EMLauncher/POV_clock/frame_B.step

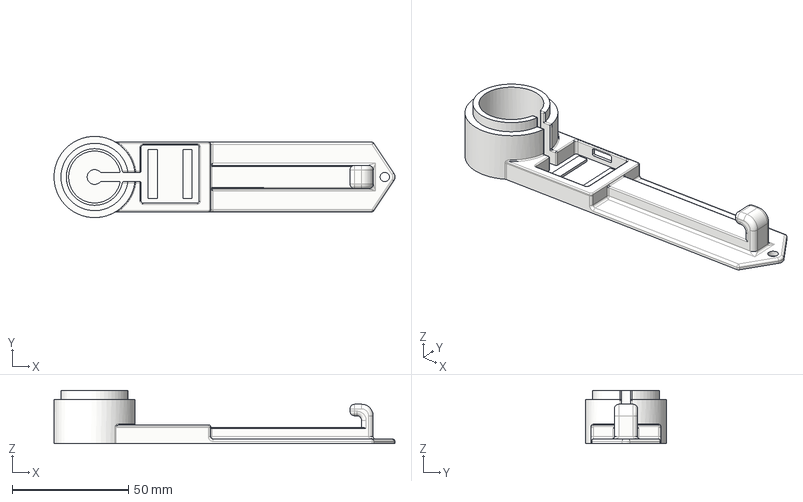
[picture p1: CAD file, 2024-11-16]
frame_B.step
146.9 x 35.0 x 23.0 mm
