EMLauncher/POV_clock/coil_frame_B.step

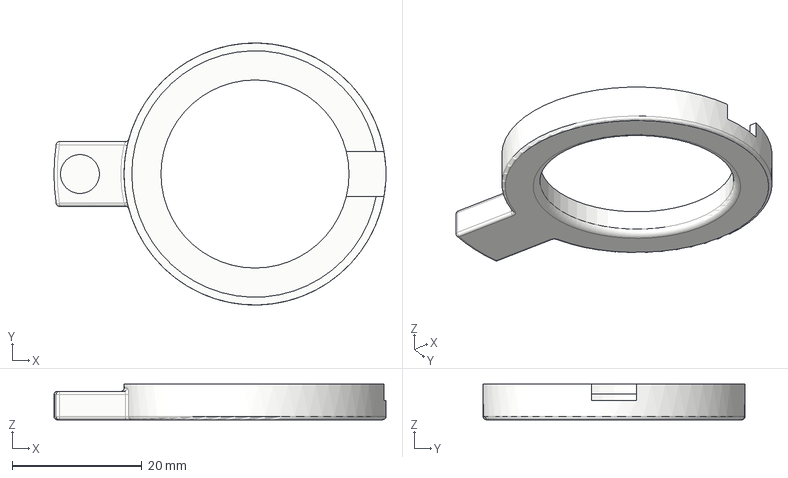
[picture p2: CAD file, 2024-11-16]
coil_frame_B.step
51.2 x 40.4 x 5.50 mm
