EMLauncher/POV_clock/POV_v011_PCB/POV_v011.kicad_pcb

## KiCad design POV_v011_PCB/POV_v011.kicad_pcb (2024-11-16)

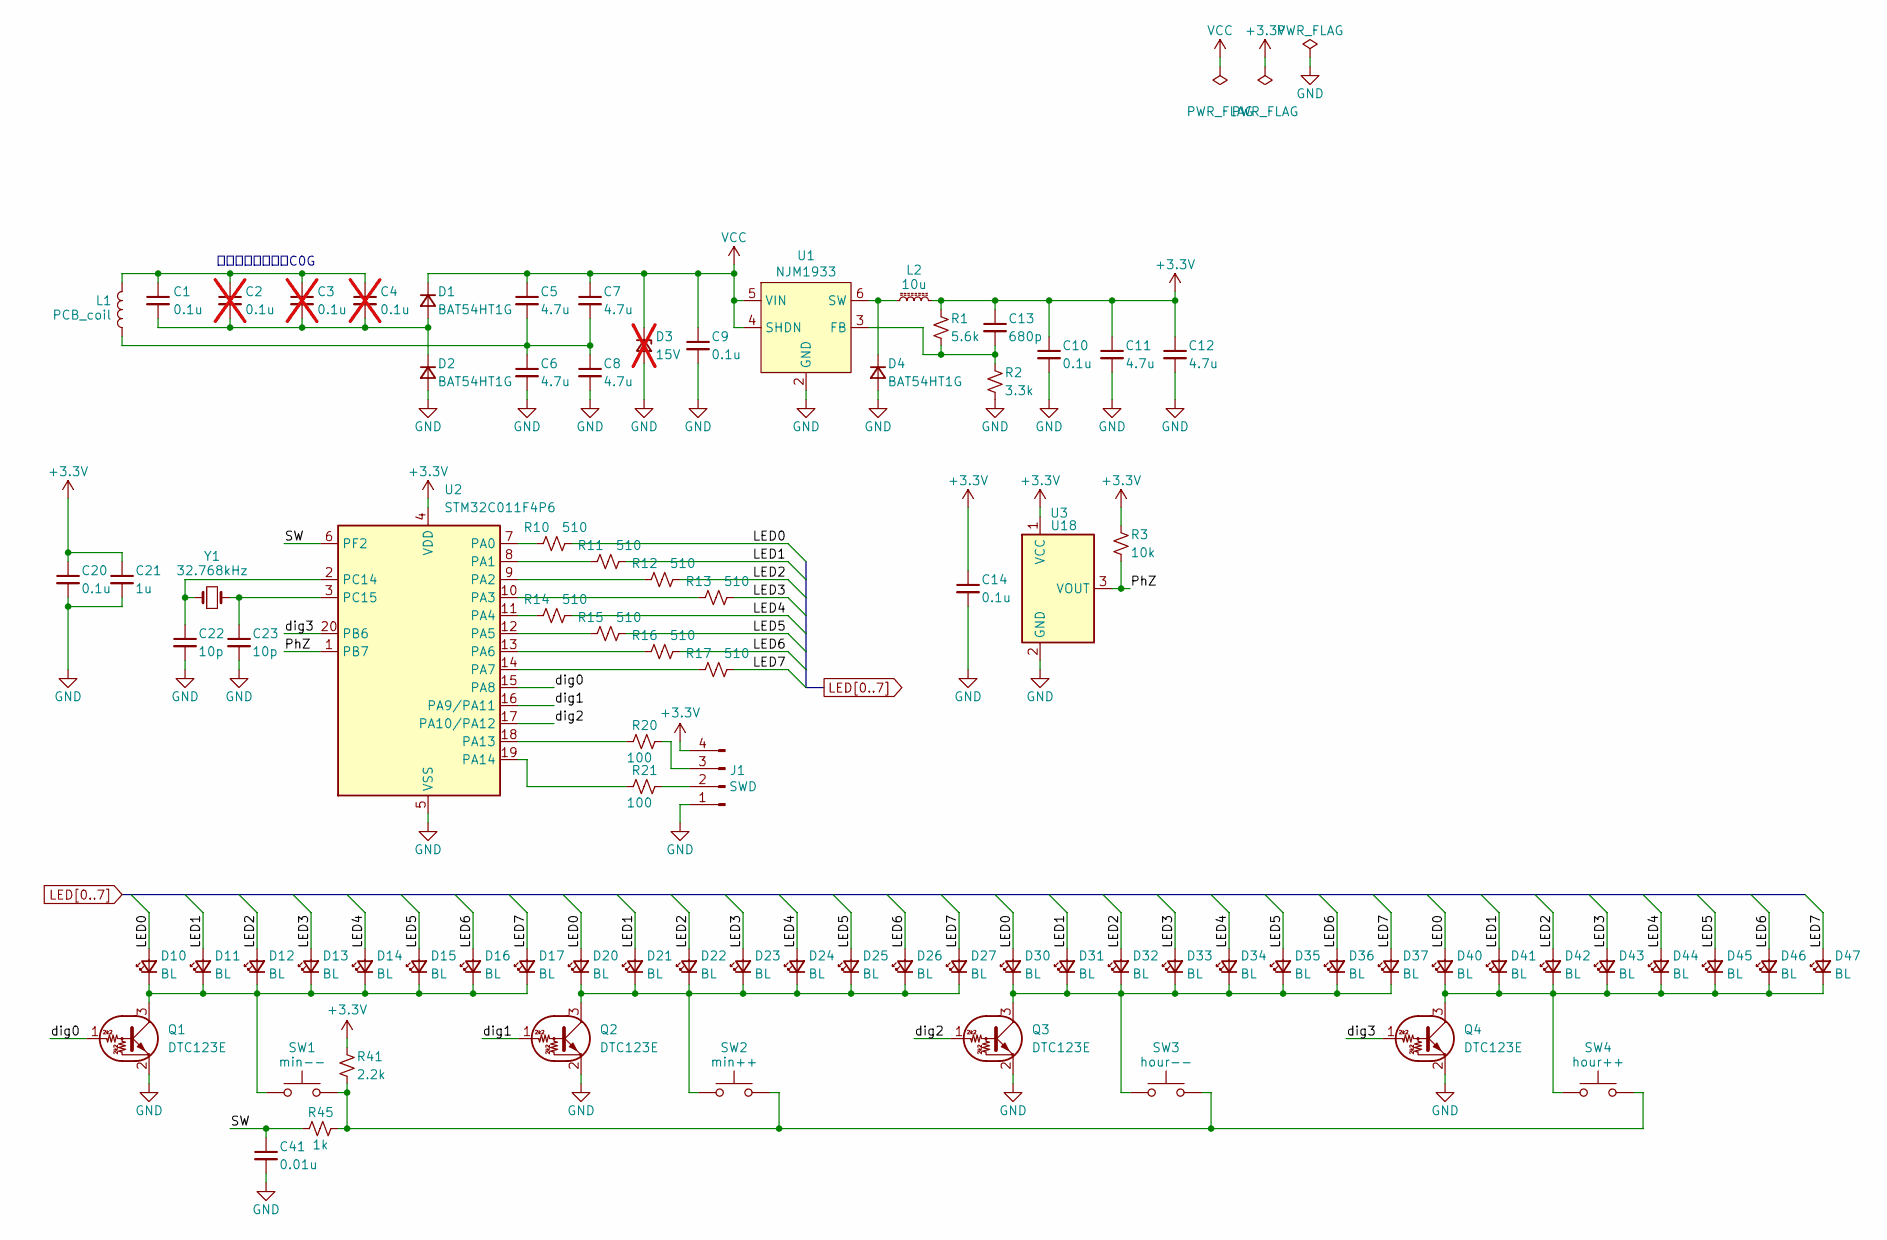
[picture p3: schematic POV_v011.kicad_sch, POV]

Parts:
C1: 0.1u; C_1206_3216Metric
C2, C3, C4: 0.1u; C_1206_3216Metric; not fitted
C5, C6, C7, C8, C11, C12: 4.7u; C_0603_1608Metric
C9, C10, C14, C20: 0.1u; C_0603_1608Metric
C13: 680p; C_0603_1608Metric
C21: 1u; C_0603_1608Metric
C22, C23: 10p; C_0603_1608Metric
C41: 0.01u; C_0603_1608Metric
D1, D2, D4: BAT54HT1G; D_SOD-323
D3: 15V; D_SMA; not fitted
D10, D11, D12, D13, D14, D15, D16, D17, D20, D21, D22, D23, D24, D25, D26, D27, D30, D31, D32, D33, D34, D35, D36, D37, D40, D41, D42, D43, D44, D45, D46, D47: BL; D_0603_1608Metric
J1: SWD; PinHeader_1x04_P2.54mm_Vertical
L1: PCB_coil; PCB_Coil_R15_L2T12
L2: 10u; L_1210_3225Metric
Q1, Q2, Q3, Q4: DTC123E; SOT-323_SC-70
R1: 5.6k; R_0603_1608Metric
R2: 3.3k; R_0603_1608Metric
R3: 10k; R_0603_1608Metric
R10, R11, R12, R13, R14, R15, R16, R17: 510; R_0603_1608Metric
R20, R21: 100; R_0603_1608Metric
R41: 2.2k; R_0603_1608Metric
R45: 1k; R_0603_1608Metric
SW1: min--; SW_Tactile_SPST_NO_Straight_CK_PTS636Sx25SMTRLFS
SW2: min++; SW_Tactile_SPST_NO_Straight_CK_PTS636Sx25SMTRLFS
SW3: hour--; SW_Tactile_SPST_NO_Straight_CK_PTS636Sx25SMTRLFS
SW4: hour++; SW_Tactile_SPST_NO_Straight_CK_PTS636Sx25SMTRLFS
U1: NJM1933; SOT-23-6
U2: STM32C011F4P6; TSSOP-20_4.4x6.5mm_P0.65mm
U3: U18; PinHeader_1x03_P1.27mm_Vertical
Y1: 32.768kHz; Crystal_SMD_3215-2Pin_3.2x1.5mm

Connections:
+3.3V: C10.1, C11.1, C12.1, C13.1, C14.1, C20.1, C21.1, J1.4, L2.2, R1.1, R3.1, R41.1, U2.4 (VDD), U3.1 (VCC)
/PhZ: R3.2, U2.1 (PB7), U3.3 (VOUT)
/SW: C41.1, R45.1, U2.6 (PF2)
/dig0: Q1.1 (B), U2.15 (PA8)
/dig1: Q2.1 (B), U2.16 (PA9/PA11)
/dig2: Q3.1 (B), U2.17 (PA10/PA12)
/dig3: Q4.1 (B), U2.20 (PB6)
GND: C6.2, C8.2, C9.2, C10.2, C11.2, C12.2, C14.2, C20.2, C21.2, C22.2, C23.2, C41.2, D2.2 (A), D3.2 (A), D4.2 (A), J1.1, Q1.2 (E), Q2.2 (E), Q3.2 (E), Q4.2 (E), R2.2, U1.2 (GND), U2.5 (VSS), U3.2 (GND)
LED0: D10.2 (A), D20.2 (A), D30.2 (A), D40.2 (A), R10.2
LED1: D11.2 (A), D21.2 (A), D31.2 (A), D41.2 (A), R11.2
LED2: D12.2 (A), D22.2 (A), D32.2 (A), D42.2 (A), R12.2
LED3: D13.2 (A), D23.2 (A), D33.2 (A), D43.2 (A), R13.2
LED4: D14.2 (A), D24.2 (A), D34.2 (A), D44.2 (A), R14.2
LED5: D15.2 (A), D25.2 (A), D35.2 (A), D45.2 (A), R15.2
LED6: D16.2 (A), D26.2 (A), D36.2 (A), D46.2 (A), R16.2
LED7: D17.2 (A), D27.2 (A), D37.2 (A), D47.2 (A), R17.2
unnamed: C1.1, C2.1, C3.1, C4.1, L1.2
unnamed: C5.2, C6.1, C7.2, C8.1, L1.1
unnamed: C1.2, C2.2, C3.2, C4.2, D1.2 (A), D2.1 (K)
unnamed: D4.1 (K), L2.1, U1.6 (SW)
unnamed: D10.1 (K), D11.1 (K), D12.1 (K), D13.1 (K), D14.1 (K), D15.1 (K), D16.1 (K), D17.1 (K), Q1.3 (C), SW1.1
unnamed: D20.1 (K), D21.1 (K), D22.1 (K), D23.1 (K), D24.1 (K), D25.1 (K), D26.1 (K), D27.1 (K), Q2.3 (C), SW2.1
unnamed: D30.1 (K), D31.1 (K), D32.1 (K), D33.1 (K), D34.1 (K), D35.1 (K), D36.1 (K), D37.1 (K), Q3.3 (C), SW3.1
unnamed: D40.1 (K), D41.1 (K), D42.1 (K), D43.1 (K), D44.1 (K), D45.1 (K), D46.1 (K), D47.1 (K), Q4.3 (C), SW4.1
unnamed: J1.2, R21.2
unnamed: J1.3, R20.2
unnamed: R41.2, R45.2, SW1.2, SW2.2, SW3.2, SW4.2
unnamed: C13.2, R1.2, R2.1, U1.3 (FB)
unnamed: R10.1, U2.7 (PA0)
unnamed: R11.1, U2.8 (PA1)
unnamed: R12.1, U2.9 (PA2)
unnamed: R13.1, U2.10 (PA3)
unnamed: R14.1, U2.11 (PA4)
unnamed: R15.1, U2.12 (PA5)
unnamed: R16.1, U2.13 (PA6)
unnamed: R17.1, U2.14 (PA7)
unnamed: R20.1, U2.18 (PA13)
unnamed: R21.1, U2.19 (PA14)
unnamed: C22.1, U2.2 (PC14), Y1.1
unnamed: C23.1, U2.3 (PC15), Y1.2
VCC: C5.1, C7.1, C9.1, D1.1 (K), D3.1 (K), U1.4 (SHDN), U1.5 (VIN)

Notes on the sheet:
共振キャパシタはC0G

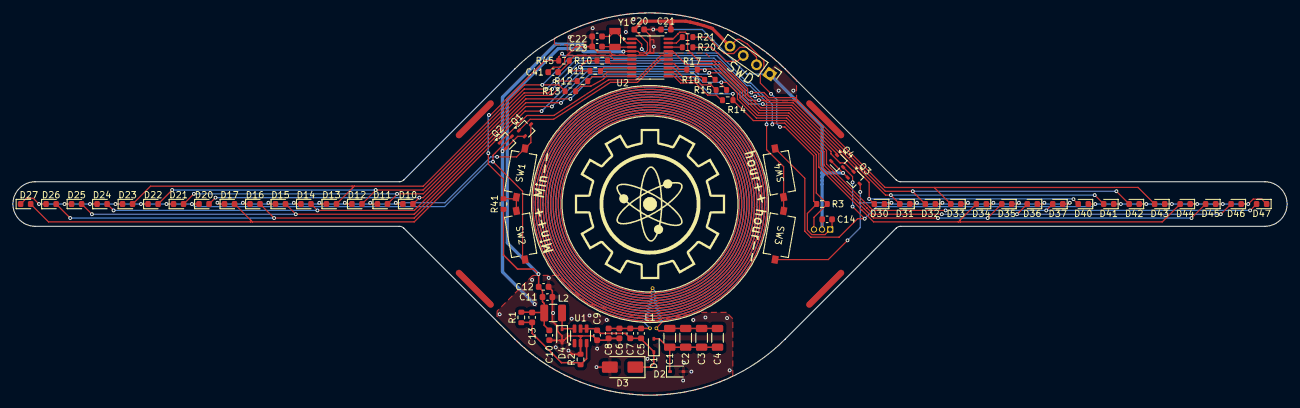
[picture p4: board POV_v011.kicad_pcb from above]

Board: 2 copper layers, 200.0 x 60.0 mm, 85 parts (1 on the bottom side), 41 nets.
