EMLauncher/POV_clock/POV_TX_PCB/POV_TX.kicad_pcb

## KiCad design POV_TX_PCB/POV_TX.kicad_pcb (2024-11-16)

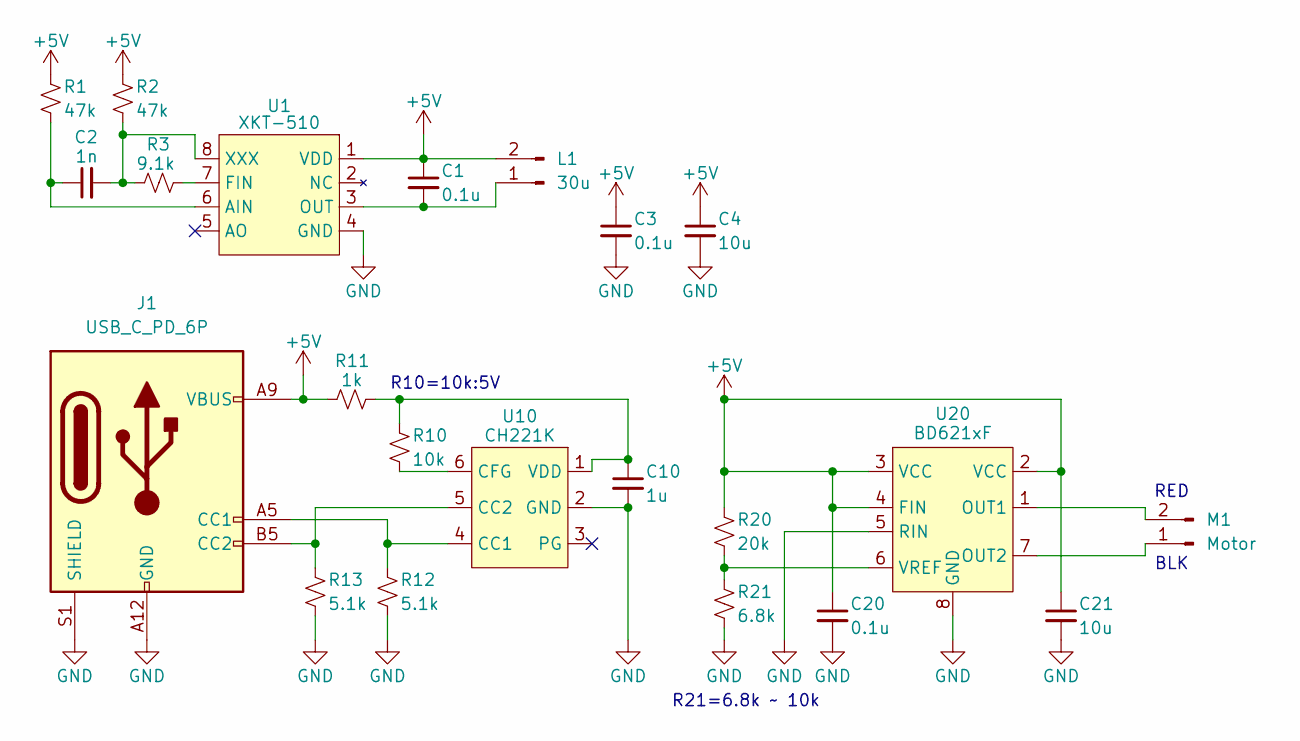
[picture p5: schematic POV_TX.kicad_sch]

Parts:
C1: 0.1u; C_1206_3216Metric
C2: 1n; C_0603_1608Metric
C3, C20: 0.1u; C_0603_1608Metric
C4, C21: 10u; C_0603_1608Metric
C10: 1u; C_0603_1608Metric
J1: USB_C_PD_6P; USB_C_Receptacle_GCT_USB4125-xx-x-0190_6P_TopMnt_Horizontal
L1: 30u; SolderWire-0.1sqmm_1x02_P3.6mm_D0.4mm_OD1mm
M1: Motor; SolderWire-0.1sqmm_1x02_P3.6mm_D0.4mm_OD1mm
R1, R2: 47k; R_0603_1608Metric
R3: 9.1k; R_0603_1608Metric
R10: 10k; R_0603_1608Metric
R11: 1k; R_0603_1608Metric
R12, R13: 5.1k; R_0603_1608Metric
R20: 20k; R_0603_1608Metric
R21: 6.8k; R_0603_1608Metric
U1: XKT-510; SOIC-8_3.9x4.9mm_P1.27mm
U10: CH221K; SOT-23-6
U20: BD621xF; SOP-8_3.9x4.9mm_P1.27mm

Connections:
+5V: C1.1, C3.1, C4.1, C20.1, C21.1, J1.A9 (VBUS), J1.B9 (VBUS), L1.2, R1.1, R2.1, R11.1, R20.1, U1.1 (VDD), U20.2 (VCC), U20.3 (VCC), U20.4 (FIN)
GND: C3.2, C4.2, C10.2, C20.2, C21.2, J1.A12 (GND), J1.B12 (GND), J1.S1 (SHIELD), R12.2, R13.2, R21.2, U1.4 (GND), U10.2 (GND), U20.5 (RIN), U20.8 (GND)
unnamed: J1.A5 (CC1), R12.1, U10.4 (CC1)
unnamed: J1.B5 (CC2), R13.1, U10.5 (CC2)
unnamed: C1.2, L1.1, U1.3 (OUT)
unnamed: M1.1, U20.7 (OUT2)
unnamed: M1.2, U20.1 (OUT1)
unnamed: C2.1, R1.2, U1.6 (AIN)
unnamed: R3.2, U1.7 (FIN)
unnamed: C2.2, R2.2, R3.1, U1.8 (XXX)
unnamed: R10.2, U10.6 (CFG)
unnamed: C10.1, R10.1, R11.2, U10.1 (VDD)
unnamed: R20.2, R21.1, U20.6 (VREF)

Notes on the sheet:
BLK
R10=10k:5V
R21=6.8k ~ 10k
RED

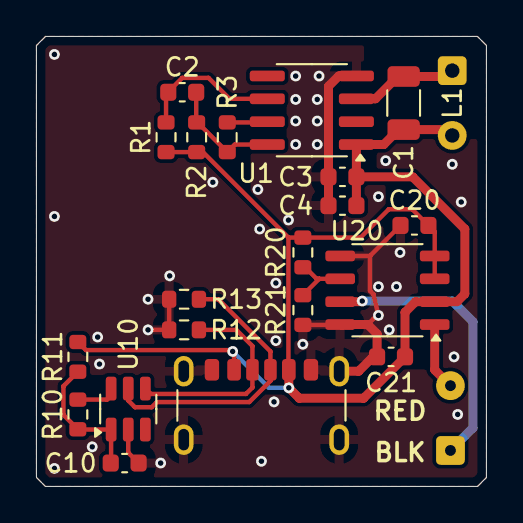
[picture p6: board POV_TX.kicad_pcb from above]

Board: 2 copper layers, 25.0 x 25.0 mm, 22 parts (0 on the bottom side), 13 nets.
