EMLauncher/POV_clock/POV_v011/Core/Src/main.c

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
/* Includes ------------------------------------------------------------------*/
#include "main.h"

/* USER CODE BEGIN Includes */
#include "PI_controller.h"
#include "draw_clock.h"
/* USER CODE END Includes */

/* USER CODE BEGIN PTD */
typedef union {
	uint8_t b[4];
	uint32_t v;
} uint8to32_t;
/* USER CODE END PTD */

/* USER CODE BEGIN PD */
#include "my_definitions.h"
/* USER CODE END PD */


RTC_HandleTypeDef hrtc;

/* USER CODE BEGIN PV */
volatile uint8_t digit = 0;
PI_ctrl_inst_q15 omegaPI;
volatile int32_t theta_q31 = 0L, // 2^31==4pi[rad] integrated angular
		omegaTs = 0L; // 2^31==4pi[rad]
volatile int16_t theta; // 2^15==4pi[rad] dumped angular
volatile uint8_t phase_zero = 0;
volatile uint32_t dispPixels[THETA_RESL] = {0x00000000};
volatile uint8_t sw_status = NO_SW_FLAG;
clock_pixel cp;
RTC_TimeTypeDef sTime;
RTC_DateTypeDef sDate;
/* USER CODE END PV */

void SystemClock_Config(void);
static void MX_GPIO_Init(void);
static void MX_RTC_Init(void);
/* USER CODE BEGIN PFP */
static void PLL_init(void);
static void TIM3_init(void);
static void EXTI_init(void);
static void const_delay(void);
/* USER CODE END PFP */

/**
  * @brief  The application entry point.
  * @retval int
  */
int main(void)
{

  /* MCU Configuration--------------------------------------------------------*/

  /* Reset of all peripherals, Initializes the Flash interface and the Systick. */
  HAL_Init();

  /* Configure the system clock */
  SystemClock_Config();

  /* Initialize all configured peripherals */
  MX_GPIO_Init();
  MX_RTC_Init();
  /* USER CODE BEGIN 2 */
  GPIOF->MODER &= GPIO_MODER_MODE2; // CubeMX does not initialize PF2. PF2:input mode.

  omegaPI.u = OMEGA_MIN; // initialize minimum omega
  omegaTs = __CALC_OMEGATS(omegaPI.u);
  PLL_init();
  EXTI_init();
  TIM3_init();
  clock_pixel_init(&cp, (uint32_t *)dispPixels);

  /* USER CODE END 2 */

  /* Infinite loop */
  /* USER CODE BEGIN WHILE */
  while (1)
  {
 	  if (phase_zero) {
		  update_PI_ctrl(&omegaPI, theta);
		  omegaTs = __CALC_OMEGATS(omegaPI.u);
		  phase_zero = 0;
	  }
 	  HAL_RTC_GetTime(&hrtc, &sTime, RTC_FORMAT_BIN);
 	  HAL_RTC_GetDate(&hrtc, &sDate, RTC_FORMAT_BIN); // You must call HAL_RTC_GetDate() after HAL_RTC_GetTime()
 	  cp.hour = sTime.Hours;
 	  cp.min = sTime.Minutes;
 	  cp.sec = sTime.Seconds;
 	  update_clock_pixel(&cp);

 	  switch(sw_status) {
 	  case MIN_INC_FLAG:
 		  if (sTime.Minutes == 59) { // if not able to ++ minutes, ++ hours
 			  sTime.Minutes = 0;
 			  sw_status = HOUR_INC_FLAG;
 		  } else {
 			  sTime.Minutes++;
 			  HAL_RTC_SetTime(&hrtc, &sTime, RTC_FORMAT_BIN);
 			  HAL_Delay(300); // avoid chattering
 			 sw_status = NO_SW_FLAG;
 		  }
 		  break;
 	  case MIN_DEC_FLAG:
 		  if (sTime.Minutes == 0) { // if not able to -- minutes, -- hours
 			  sTime.Minutes = 59;
 			  sw_status = HOUR_DEC_FLAG;
 		  } else {
 			  sTime.Minutes--;
 			  HAL_RTC_SetTime(&hrtc, &sTime, RTC_FORMAT_BIN);
 			  HAL_Delay(300); // avoid chattering
 			  sw_status = NO_SW_FLAG;
 		  }
 		  break;
 	  case HOUR_INC_FLAG:
 		  if (sTime.Hours == 12) {
 			  sTime.Hours = 1;
 		  } else {
 			  sTime.Hours++;
 		  }
 		  HAL_RTC_SetTime(&hrtc, &sTime, RTC_FORMAT_BIN);
 		  HAL_Delay(300); // avoid chattering
 		  sw_status = NO_SW_FLAG;
 		  break;
 	 case HOUR_DEC_FLAG:
 	  	  if (sTime.Hours == 1) {
 	  		  sTime.Hours = 12;
 	  	  } else {
 	 	 	  sTime.Hours--;
 	  	  }
 	  	  HAL_RTC_SetTime(&hrtc, &sTime, RTC_FORMAT_BIN);
 	  	  HAL_Delay(300); // avoid chattering
 	  	  sw_status = NO_SW_FLAG;
 	  	  break;
 	 default:
 		 break;
 	  }
    /* USER CODE END WHILE */

    /* USER CODE BEGIN 3 */
  }
  /* USER CODE END 3 */
}

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
/* USER CODE BEGIN 4 */
// synchronize theta
static void PLL_init(void) {
	omegaPI.Kp = PLL_KP;
	omegaPI.Kp_decimal = PLL_KP_DECIMAL;
	omegaPI.TsTi = PLL_TSTI;
	omegaPI.y_target = Q15_2PI;
	omegaPI.u_max = OMEGA_MAX;
	omegaPI.u_min = OMEGA_MIN;
	init_PI_ctrl(&omegaPI, Q15_2PI);

	return;
}

// EXTI for PB7
static void EXTI_init(void) {
	// initialize EXTI
	EXTI->FTSR1 |= EXTI_FTSR1_FT7; // falling edge enable on Line 7
	EXTI->EXTICR[1] |= (0x01 << EXTI_EXTICR1_EXTI3_Pos); // select PB7
	EXTI->IMR1 |= EXTI_IMR1_IM7; // disable CPU wake-up mask Line7
	NVIC_EnableIRQ(EXTI4_15_IRQn); // enable interrupt on Line 4 to 15
	return;
}

void EXTI4_15_IRQHandler(void) {
	if (EXTI->FPR1 & EXTI_FPR1_FPIF7) {
		// Line 7 falling edge
		theta = theta_q31 >> 16;
		theta_q31 = 0L;
		phase_zero = 1;
		EXTI->FPR1 = EXTI_FPR1_FPIF7; // clear flag (cleared by writing "1" into bit)
	}
}

static void TIM3_init(void) {
	// initialize TIM3
	RCC->APBENR1 |= RCC_APBENR1_TIM3EN; // clock enable
	TIM3->CR1 |= TIM_CR1_ARPE; // Auto-reload preload enable
	TIM3->CR1 &= ~(TIM_CR1_CMS | TIM_CR1_DIR); // edge-aligned mode, upcounter
	TIM3->CR1 |= TIM_CR1_URS; // only overflow generate UEV
	TIM3->DIER |= TIM_DIER_UIE; // interrupt enable
	TIM3->PSC = 48 - 1; // prescaler 1/48
	TIM3->ARR = 25 - 1; // period=25us @48MHz
	NVIC_EnableIRQ(TIM3_IRQn);
	TIM3->CR1 |= TIM_CR1_CEN; // timer enable
	return;
}

// TIM3 interrupt
void TIM3_IRQHandler(void) {
	TIM3->DIER &= ~TIM_DIER_UIE;

	// update display
	theta_q31 += omegaTs;
	if (theta_q31 < 0) { // overflow theta
		theta_q31 = Q31_4PI;
	}
	uint16_t theta_idx = theta_q31 >> THETA_FIX_Pos;
	theta_idx %= THETA_RESL;
	GPIOA->ODR &= ~LED8BIT_msk;
	uint8to32_t dispPix; // これから表示するピクセルの値, 32bitに代入して8bitずつ取り出su

	// turn ON selected digit & turn OFF previous digit
	switch (digit) {
	case 0:
		if (!(GPIOF->IDR & (1UL << 2))) { // PF2 (SW pin) is 0
			sw_status = HOUR_INC_FLAG;
		}
		GPIOB->ODR &= ~DIG3_msk; // turn OFF DIG3
		dispPix.v = dispPixels[theta_idx];
		const_delay(); // not for display ghost
		GPIOA->ODR |= (LED8BIT_msk & dispPix.b[2]); // update pixel
		GPIOA->ODR |= DIG0_msk; // turn ON DIG0
		break;
	case 1:
		if (!(GPIOF->IDR & (1UL << 2))) {
			sw_status = MIN_DEC_FLAG;
		}
		GPIOA->ODR &= ~DIG0_msk; // turn OFF DIG0
		dispPix.v = dispPixels[theta_idx];
		const_delay(); // not for display ghost
		GPIOA->ODR |= (LED8BIT_msk & dispPix.b[3]);
		GPIOA->ODR |= DIG1_msk; // turn ON DIG1
		break;
	case 2:
		if (!(GPIOF->IDR & (1UL << 2))) {
			sw_status = MIN_INC_FLAG;
		}
		GPIOA->ODR &= ~DIG1_msk; // turn OFF DIG1
		dispPix.v = dispPixels[(theta_idx + (THETA_RESL >> 1)) % THETA_RESL]; // add to theta 180 deg.
		const_delay(); // not for display ghost
		GPIOA->ODR |= (LED8BIT_msk & dispPix.b[0]);
		GPIOA->ODR |= DIG2_msk; // turn ON DIG2
		break;
	case 3:
		if (!(GPIOF->IDR & (1UL << 2))) {
			sw_status = HOUR_DEC_FLAG;
		}
		GPIOA->ODR &= ~DIG2_msk; // turn OFF DIG2
		dispPix.v = dispPixels[(theta_idx + (THETA_RESL >> 1)) % THETA_RESL];
		const_delay(); // not for display ghost
		GPIOA->ODR |= (LED8BIT_msk & dispPix.b[1]);
		GPIOB->ODR |= DIG3_msk; // turn ON DIG3
		break;
	default:
		// do nothing
		break;
	}
	digit++;
	digit %= 4;

	TIM3->SR &= ~TIM_SR_UIF; // clear pending flag
	TIM3->DIER |= TIM_DIER_UIE;
}

static void __attribute__((optimize("O0"))) const_delay(void) {
	uint16_t foo = 0;

	/*
	 * memo
	 * 0 NG ghost
	 * 1 OK no ghost
	 * 10 OK no ghost
	 */
	while (foo < 1) {
		foo++;
	}

	return;
}
/* USER CODE END 4 */
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
