EMLauncher/POV_clock/POV_v011/POV_v011.ioc

Mcu.UserName=STM32C011F4Px
PA0.Signal=GPIO_Output
PA1.Signal=GPIO_Output
PA13.Signal=DEBUG_SWDIO
PA14-BOOT0.Signal=DEBUG_SWCLK
PA2.Signal=GPIO_Output
PA3.Signal=GPIO_Output
PA4.Signal=GPIO_Output
PA5.Signal=GPIO_Output
PA6.Signal=GPIO_Output
PA7.Signal=GPIO_Output
PA8.Signal=GPIO_Output
PB6.Signal=GPIO_Output
PB7.Signal=GPIO_Input
PF2-NRST.Signal=GPIO_Input
